BYee7127/LEDWaterFountain/images/LEDStripLightTest.jpg

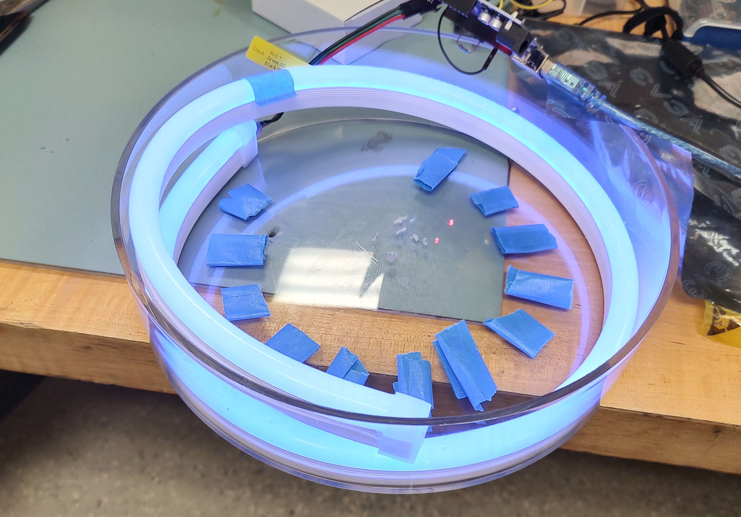
images/LEDStripLightTest.jpg
