BYee7127/LEDWaterFountain/README.md

Mission Statement
The Bellagio's mini-me: a dance of water fountains to the beat of any chosen musical piece and is highlighted by LEDs. 
The height of the water and the intensity or color of the LEDs is determined by the frequency/pitch of the music. 

Final Report:
https://github.com/BYee7127/VisualizeTheInvisible/blob/main/Documents/FinalReport.pdf
