BYee7127/LEDWaterFountain/images/AllResistorsFinished.jpg

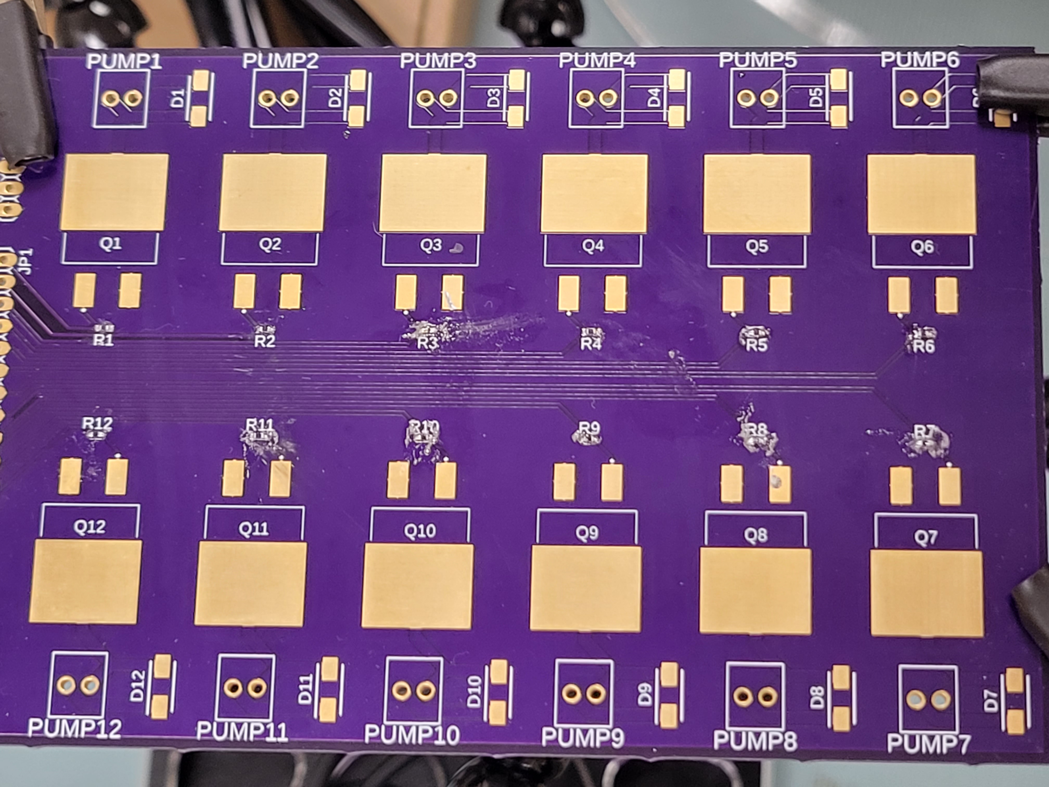
images/AllResistorsFinished.jpg
