BYee7127/LEDWaterFountain/images/AllResistorsFinished_SideView.jpg

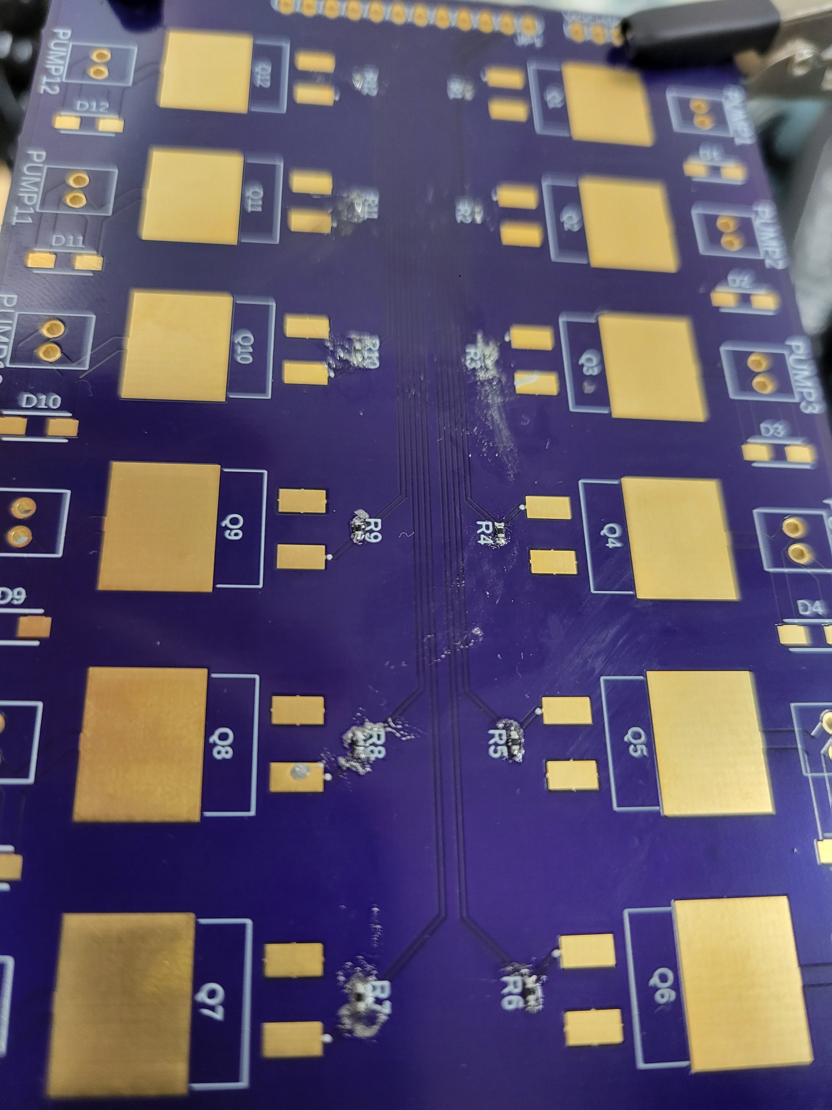
images/AllResistorsFinished_SideView.jpg
