BYee7127/LEDWaterFountain/images/AUXCord.jpg

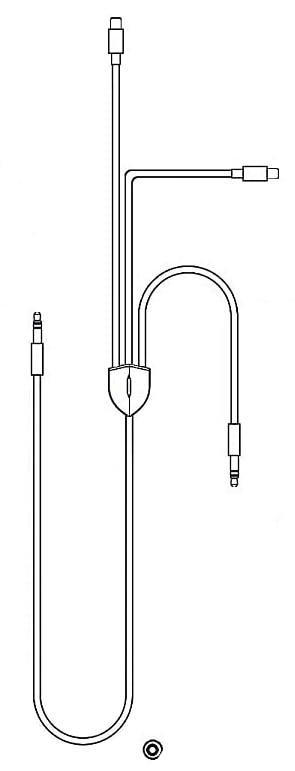
images/AUXCord.jpg
