BYee7127/LEDWaterFountain/images/CompletedCircuitBoard.jpg

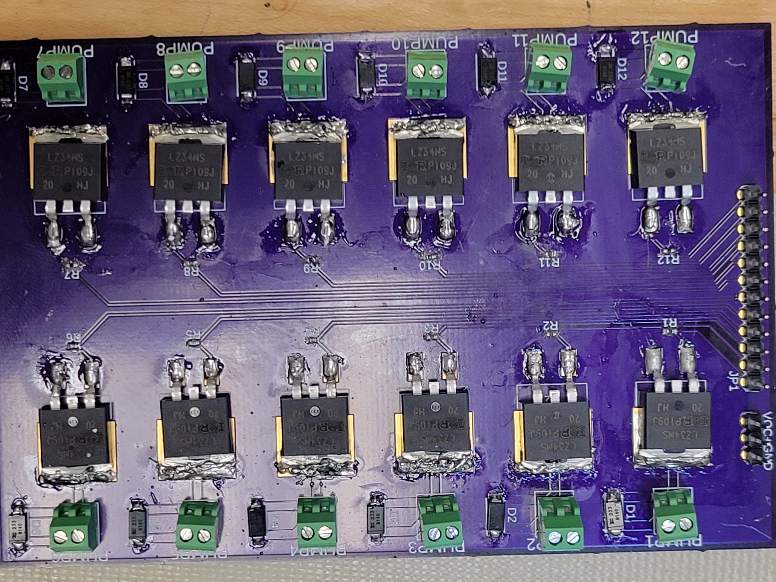
images/CompletedCircuitBoard.jpg
