BYee7127/LEDWaterFountain/images/CutOutTrays.jpg

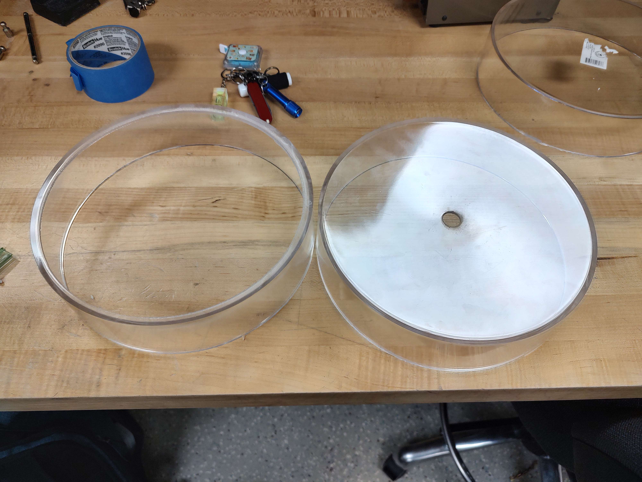
images/CutOutTrays.jpg
