BYee7127/LEDWaterFountain/images/FinishedDriverCloseup.jpg

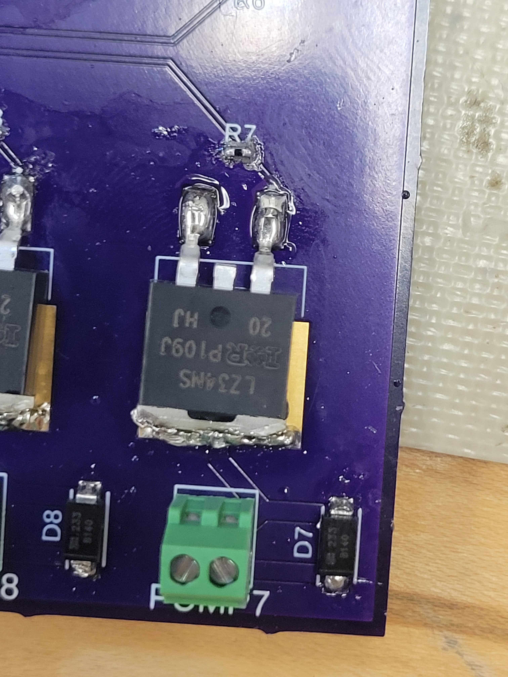
images/FinishedDriverCloseup.jpg
