BYee7127/LEDWaterFountain/images/FinishedDriverx2.jpg

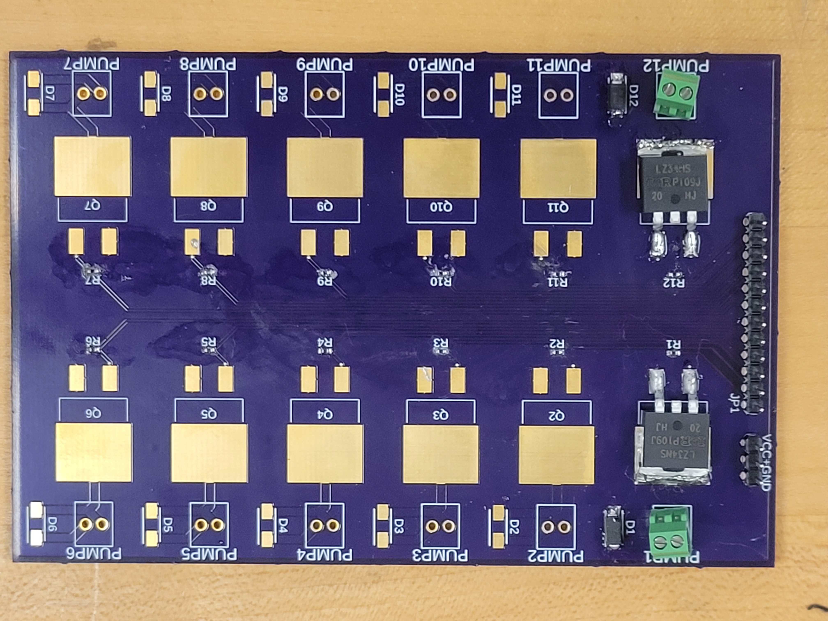
images/FinishedDriverx2.jpg
