BYee7127/LEDWaterFountain/images/PrototypeWithLED.jpg

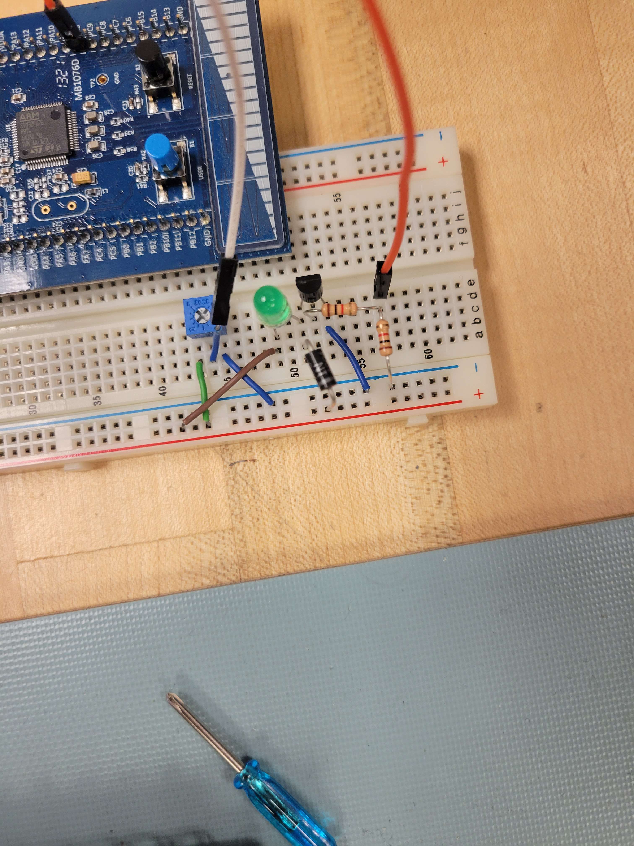
images/PrototypeWithLED.jpg
