BYee7127/LEDWaterFountain/images/PrototypeWithLEDCropped.jpg

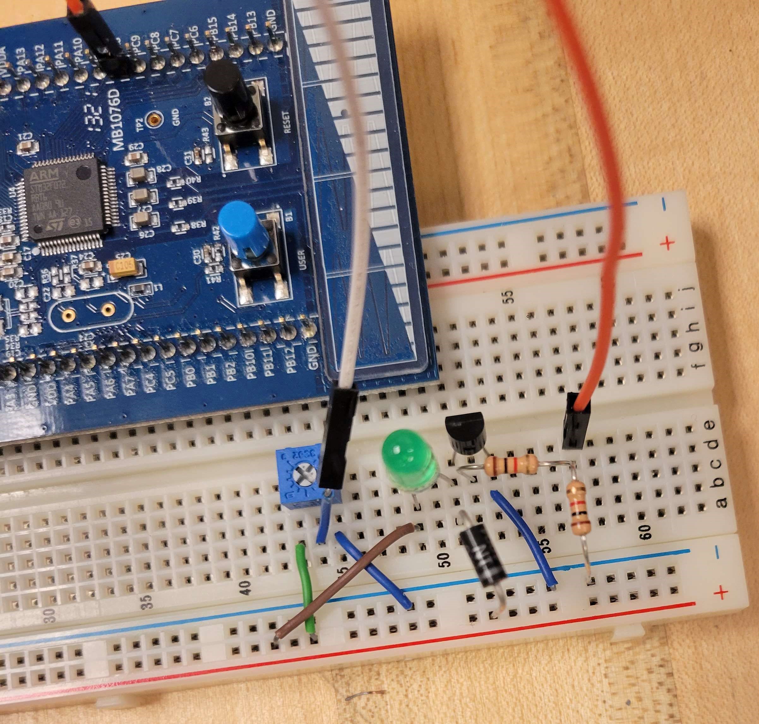
images/PrototypeWithLEDCropped.jpg
