BYee7127/LEDWaterFountain/images/PumpDriverwResistors.jpg

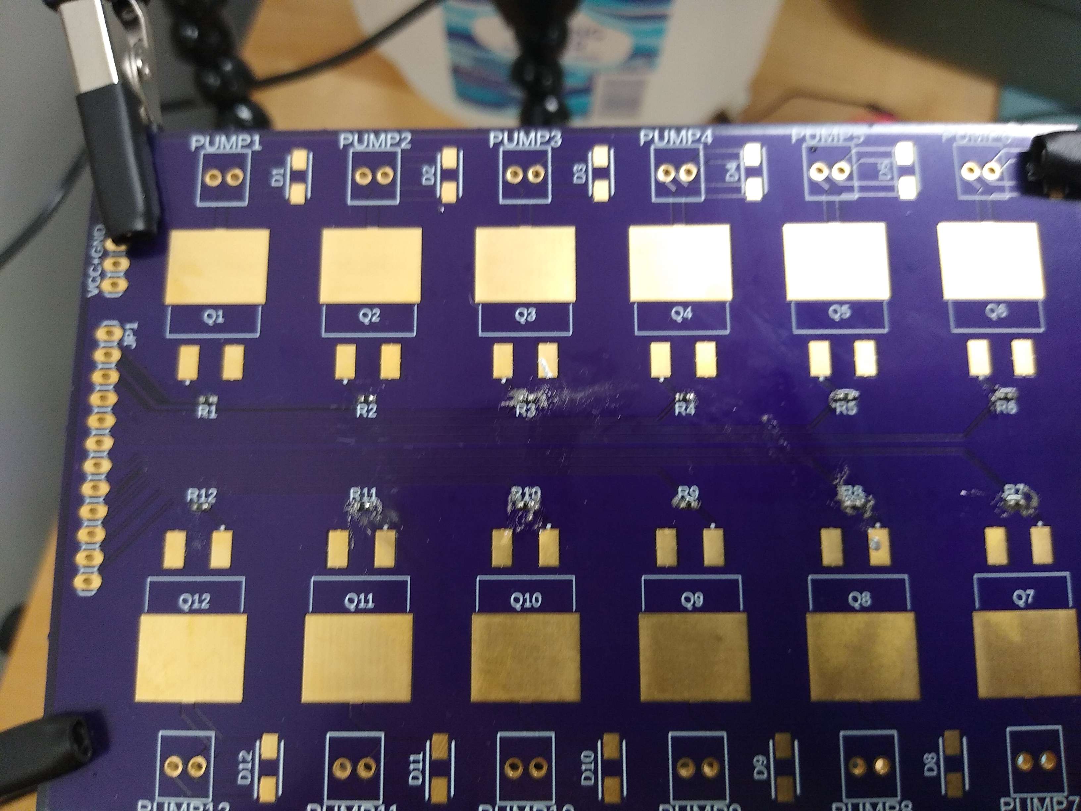
images/PumpDriverwResistors.jpg
