BYee7127/LEDWaterFountain/images/PumpsPositioned.jpg

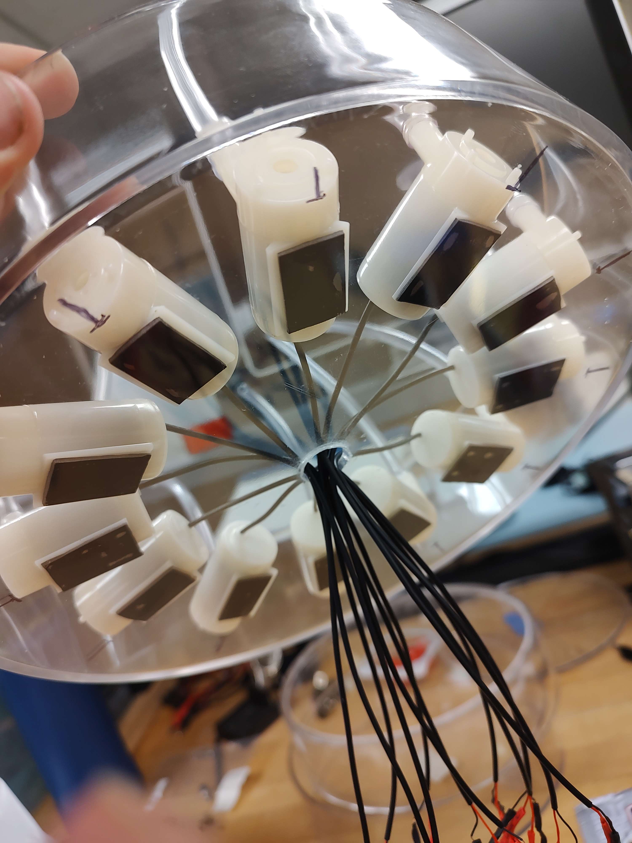
images/PumpsPositioned.jpg
