BYee7127/LEDWaterFountain/images/PumpsPositions_TopView.jpg

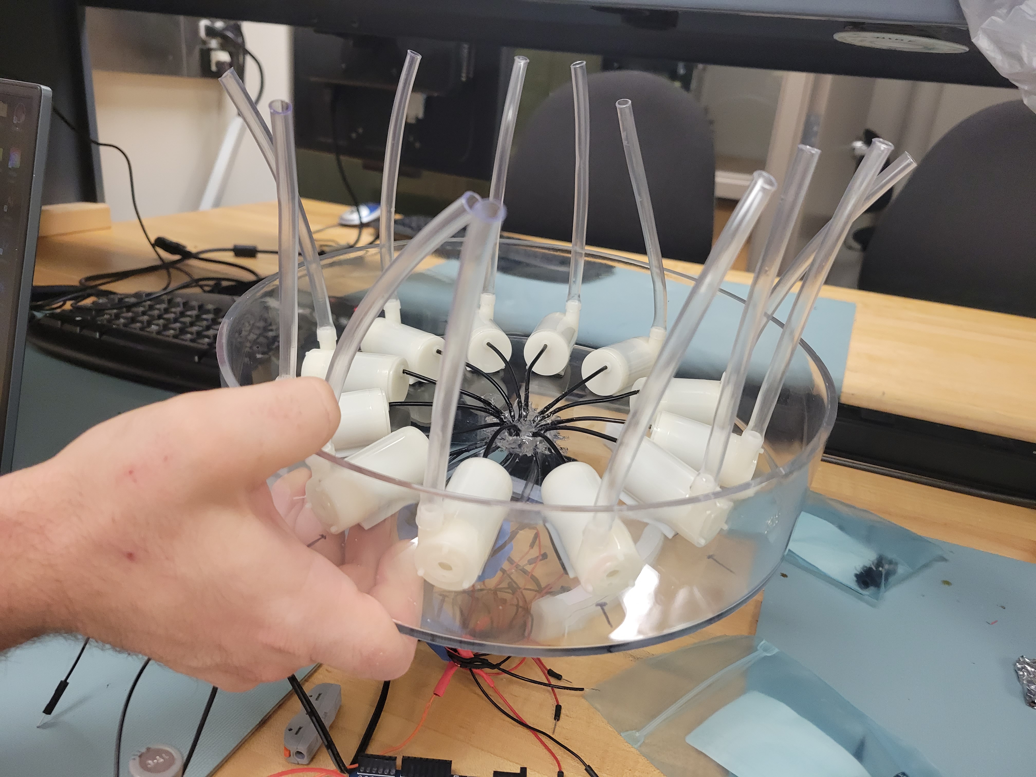
images/PumpsPositions_TopView.jpg
