BYee7127/LEDWaterFountain/images/PWMConnections.jpg

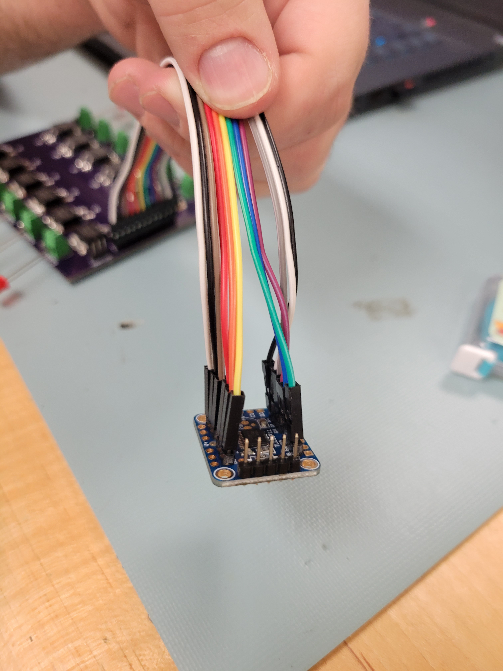
images/PWMConnections.jpg
