BYee7127/LEDWaterFountain/images/StagePreview.jpg

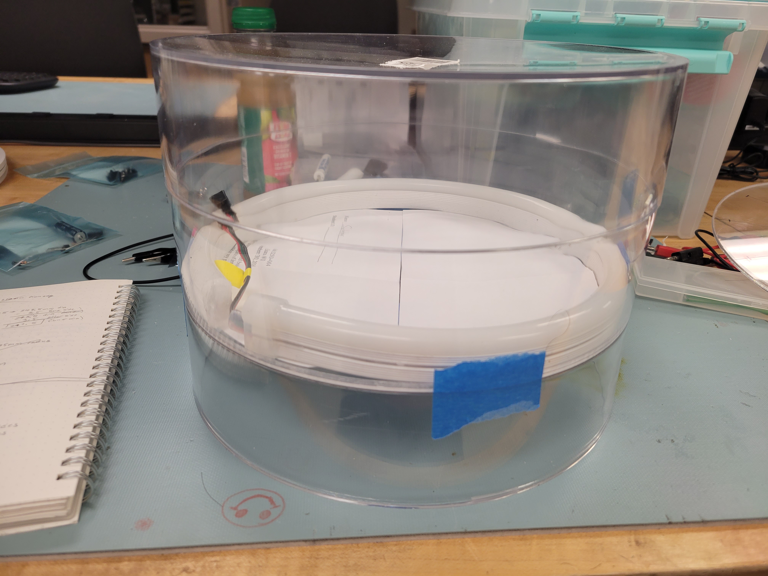
images/StagePreview.jpg
