BYee7127/LEDWaterFountain/images/StagePreview_TopView.jpg

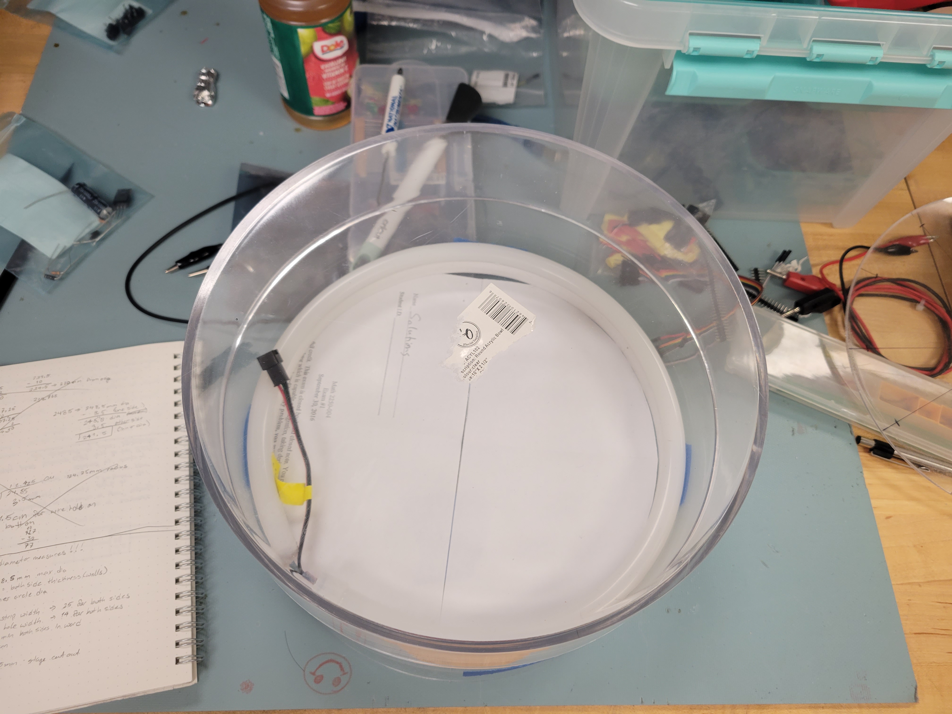
images/StagePreview_TopView.jpg
