BYee7127/LEDWaterFountain/images/StageWithTubeHolesOnlySide.jpg

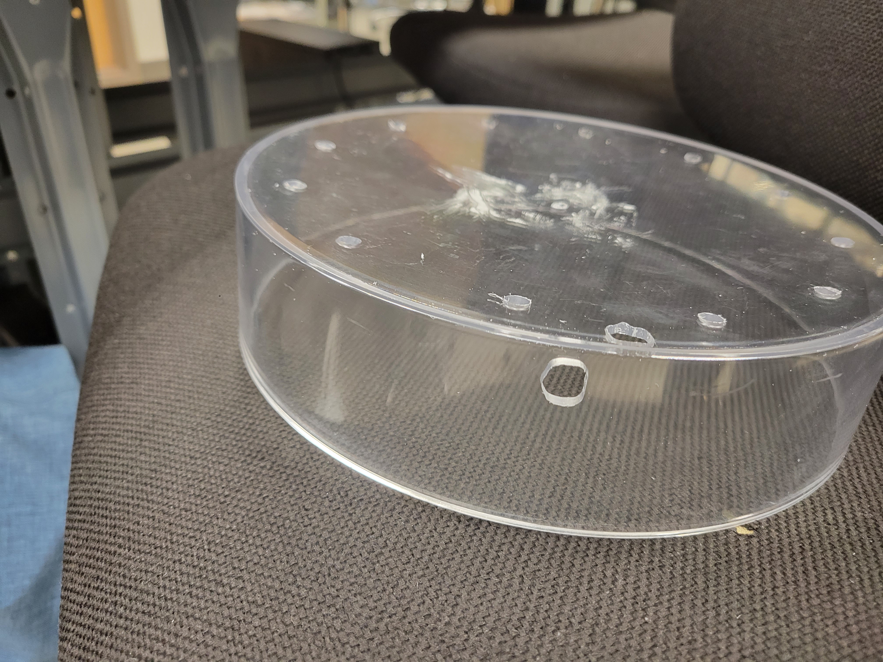
images/StageWithTubeHolesOnlySide.jpg
