BYee7127/LEDWaterFountain/images/Stand+RightSpeakerFront.jpg

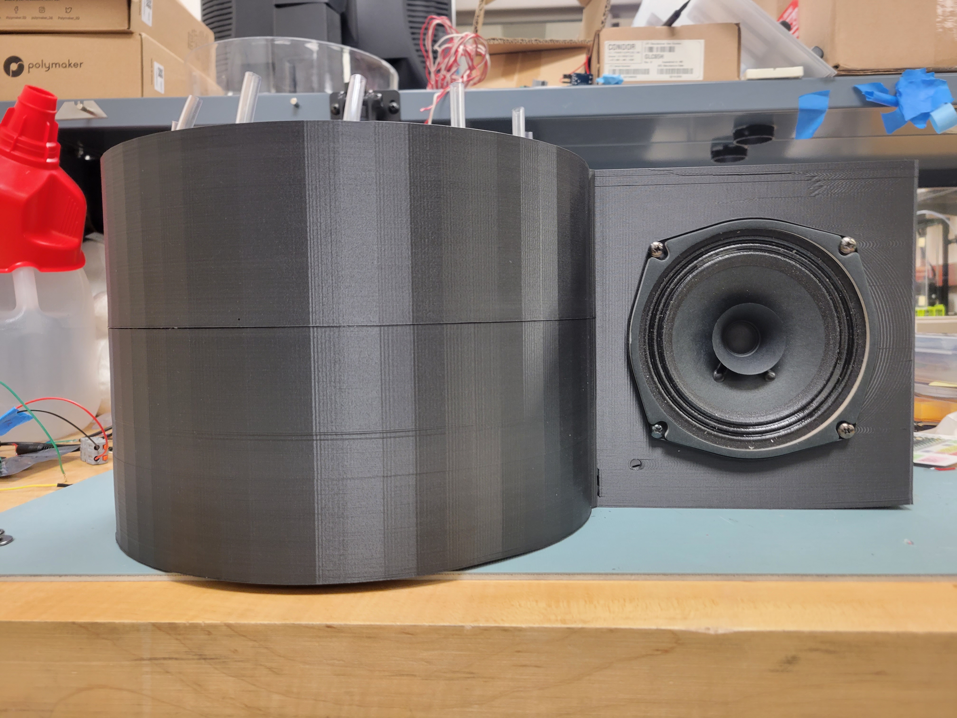
images/Stand+RightSpeakerFront.jpg
