BYee7127/LEDWaterFountain/images/Stand+RightSpeakerTop.jpg

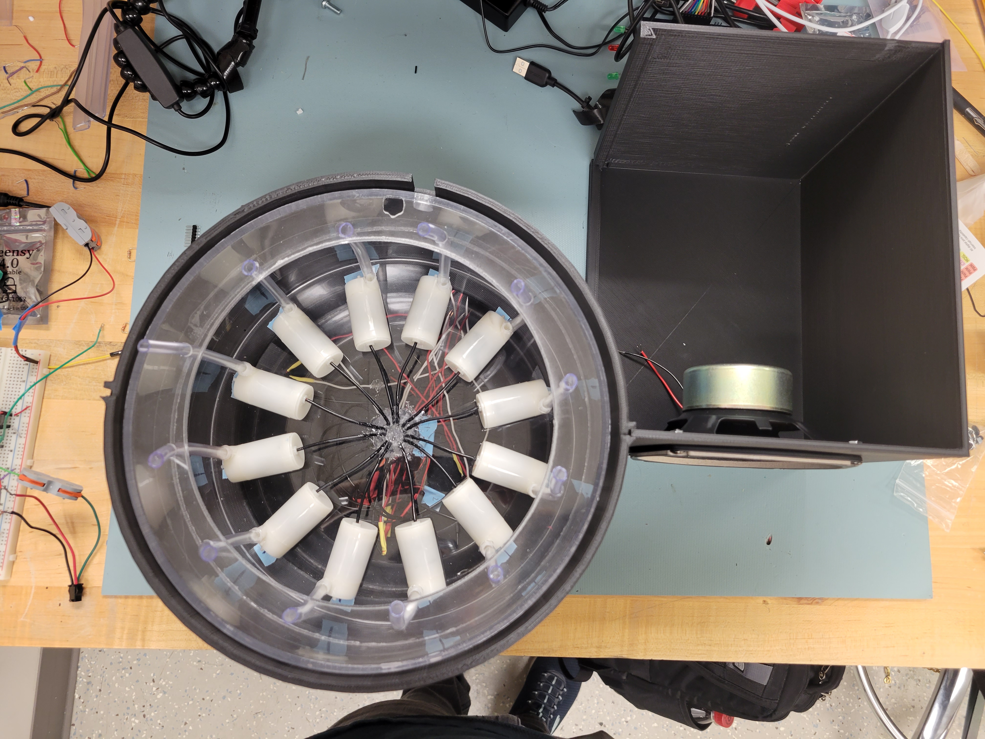
images/Stand+RightSpeakerTop.jpg
