BYee7127/LEDWaterFountain/images/Stand+RightSpeakerTopFront.jpg

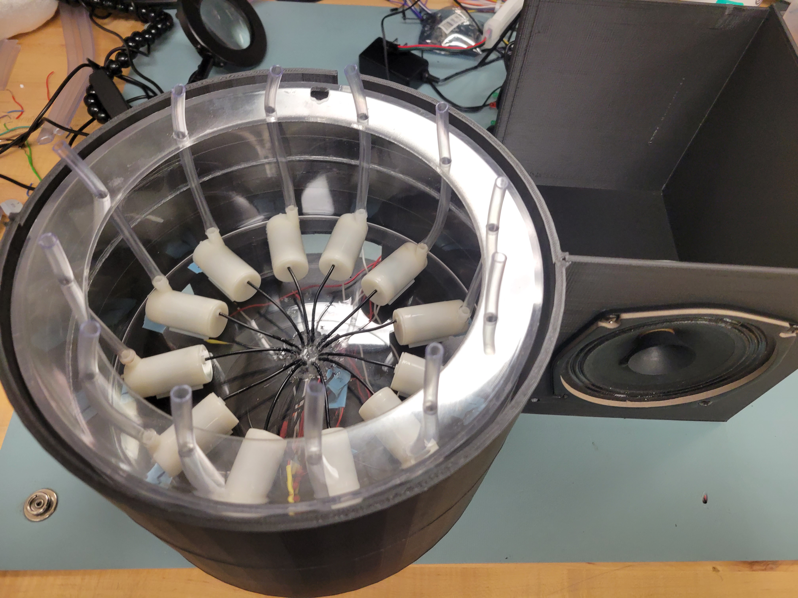
images/Stand+RightSpeakerTopFront.jpg
