BYee7127/LEDWaterFountain/images/teensy40_card10a_rev2.png

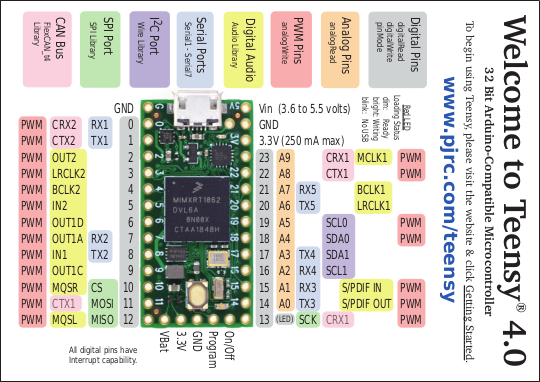
images/teensy40_card10a_rev2.png
