BYee7127/LEDWaterFountain/images/TentSideView.jpg

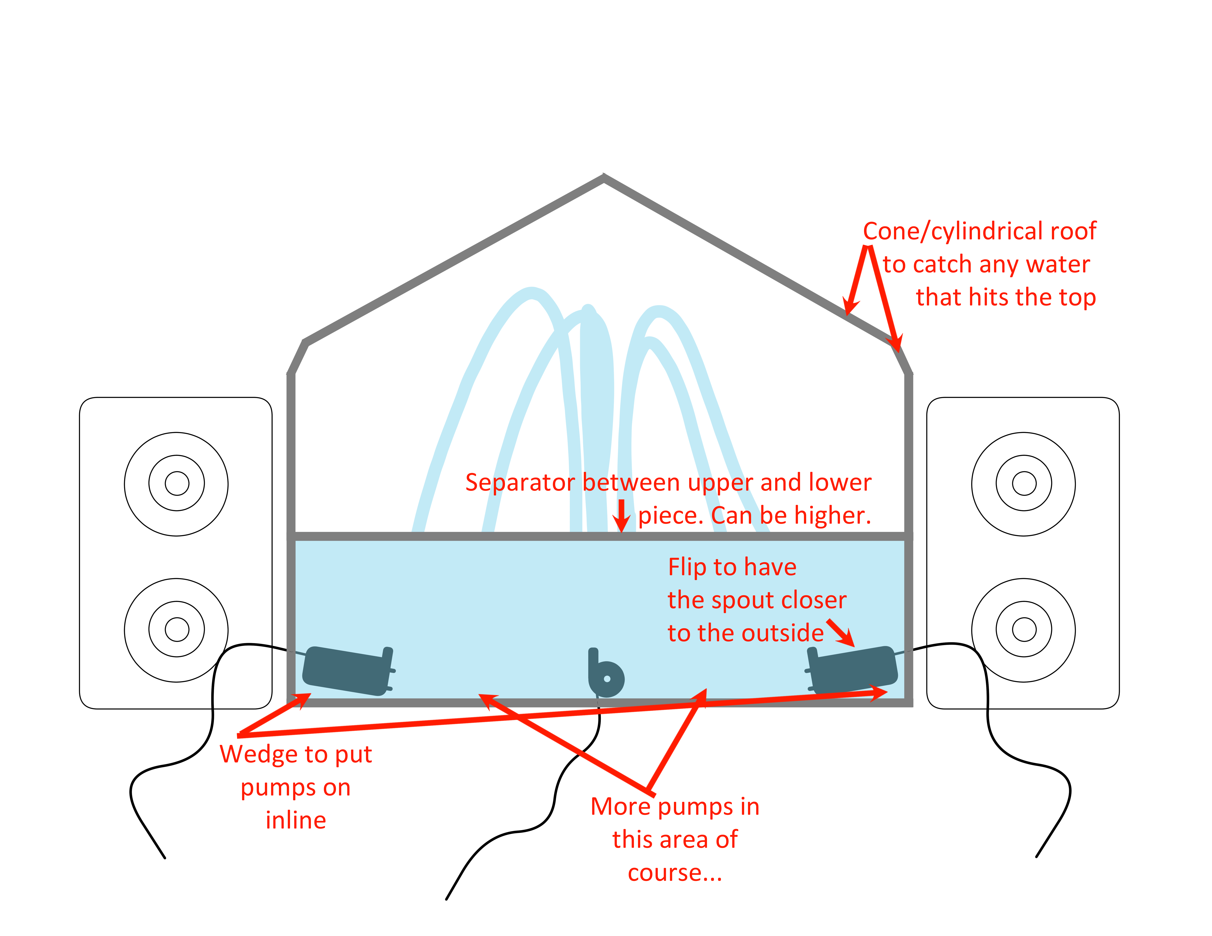
images/TentSideView.jpg
