BYee7127/LEDWaterFountain/images/TentTopView.jpg

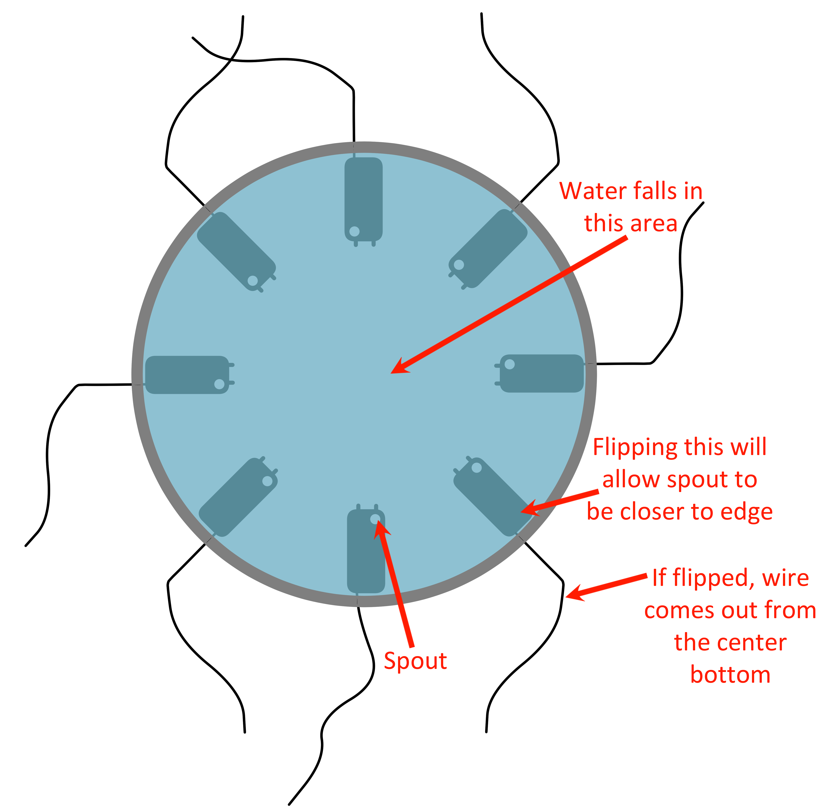
images/TentTopView.jpg
