BYee7127/LEDWaterFountain/images/WaterFountainStandTinkercad.png

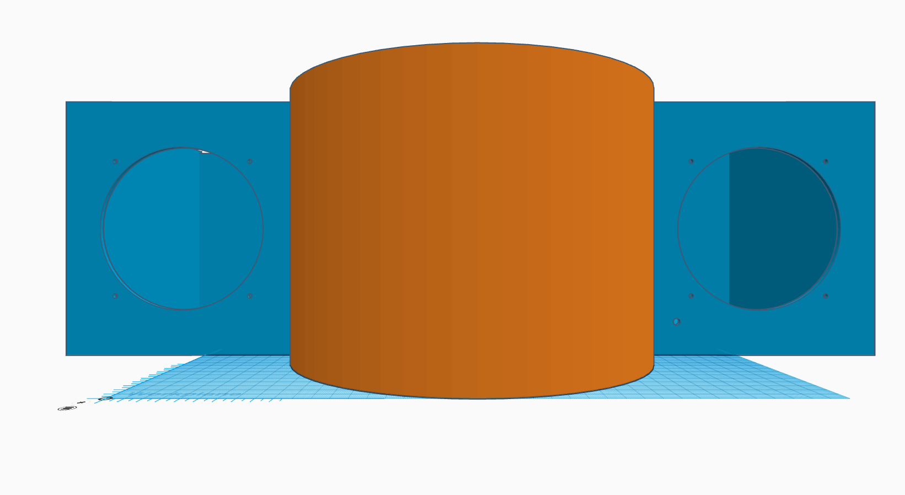
images/WaterFountainStandTinkercad.png
