BYee7127/LEDWaterFountain/Documents/Digi-Key Order.xlsx

# | QUANTITY | PART NUMBER | MANUFACTURER PART NUMBER | DESCRIPTION | CUSTOMER REFERENCE | BACKORDER | UNIT PRICE | EXTENDED PRICE
1 | 3 | 2092-STX-3120-3B-ND | STX-3120-3B | CONN JACK STEREO 3.5MM PCB R/A |  | 0 | 0.84 | 2.52
2 | 16 | IRLZ34NSTRLPBFCT-ND | IRLZ34NSTRLPBF | MOSFET N-CH 55V 30A D2PAK |  | 0 | 1.53 | 24.48
3 | 16 | 311-1.00KLRCT-ND | RC0402FR-071KL | RES 1K OHM 1% 1/16W 0402 |  | 0 | 0.015 | 0.24
4 | 16 | B140-FDICT-ND | B140-13-F | DIODE SCHOTTKY 40V 1A SMA |  | 0 | 0.316 | 5.06
5 | 16 | A98333-ND | 282834-2 | TERM BLK 2P SIDE ENT 2.54MM PCB |  | 0 | 1.288 | 20.61
