BYee7127/LEDWaterFountain/Documents/ExpensesCalculator.xlsx

Item | Item # | Purchase Date | Vendor | Qty (ea) | Price (ea) | Alex | Bev | Comments
water pumps |  |  |  |  |  | 45.44
trays |  |  |  |  |  |  | 44.02
sealant |  |  |  |  |  | 7.51
double sided tape |  |  |  |  |  | 9.63
clear tape |  |  |  |  |  | 8.97
acrylic sheets |  |  |  |  |  | 8.88
pcb |  |  |  |  |  | 71.45
power supply |  |  |  |  |  |  | 17.69
audio port |  |  |  |  |  |  | 2.52
transistors |  |  |  |  |  |  | 24.48
resistors |  |  |  |  |  |  | 0.24
diodes |  |  |  |  |  |  | 5.06
terminal blocks |  |  |  |  |  |  | 20.61
digi-key fees |  |  |  |  |  |  | 11.45
solder paste |  | 2023-05-12 |  |  |  |  | 12.82
LED strip lights |  |  |  |  |  |  | 73.96
contour tool |  | 2023-04-19 |  |  |  |  | 11.79
electronic silicone |  | 2023-08-07 |  |  |  |  | 10.67
shears |  | 2023-07-13 |  |  |  | 12.53
Audio adapter |  | 2023-08-31 |  |  |  | 13.25
PLA filament |  | 2023-08-31 |  |  |  | 22.51
H clip hinge |  | 2023-08-31 |  |  |  | 25.73
Teensy 4.0 |  | 2023-09-16 |  |  |  | 25.73 |  | 23.99
PLA filament |  | 2023-10-10 |  |  |  | 36.02
RainX water repellent |  | 2023-12-03 |  |  |  | 7.7
 |  |  |  |  |  | 295.35 | 235.31
 |  |  |  |  |  | 530.66
 |  |  |  |  |  |  | 3.98
 |  |  |  |  |  |  | 6.98
 |  |  |  |  |  |  | 10.48
 |  |  |  |  |  |  | 8.98
 |  |  |  |  |  |  | 265.73
