BYee7127/LEDWaterFountain/images/ASolderedResistor.jpg

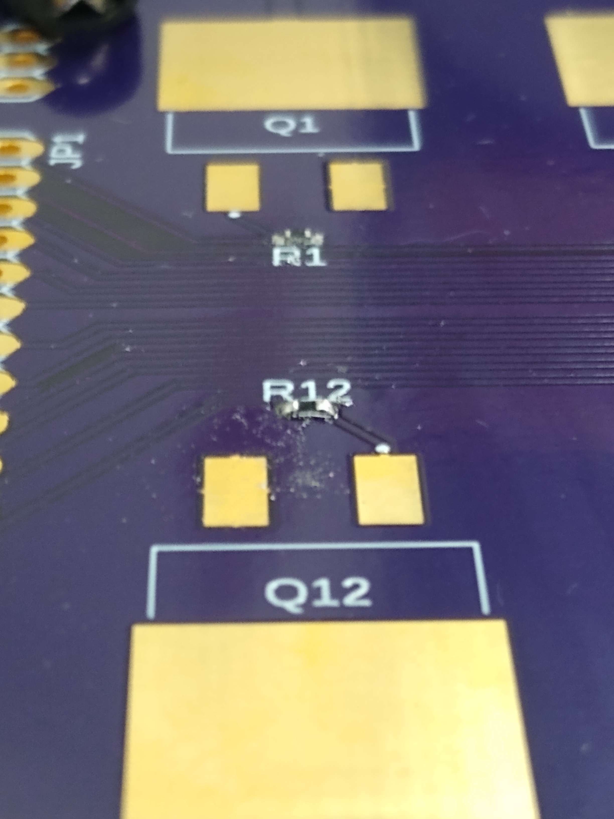
images/ASolderedResistor.jpg
