BYee7127/LEDWaterFountain/images/CircuitAssembly.jpg

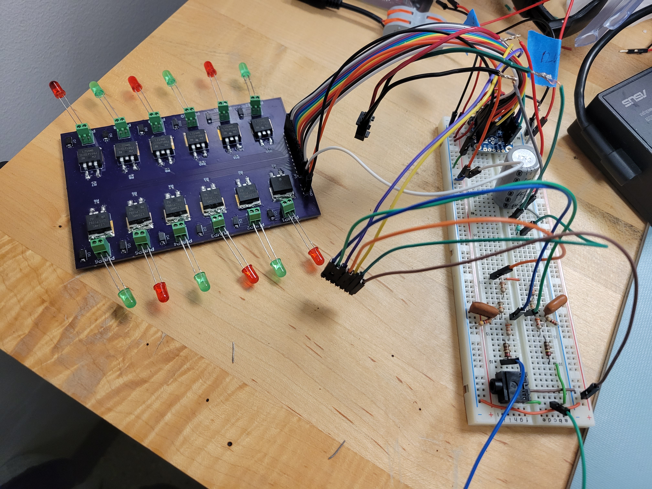
images/CircuitAssembly.jpg
