BYee7127/LEDWaterFountain/images/FullTrayMockAssemblyTopSide.jpg

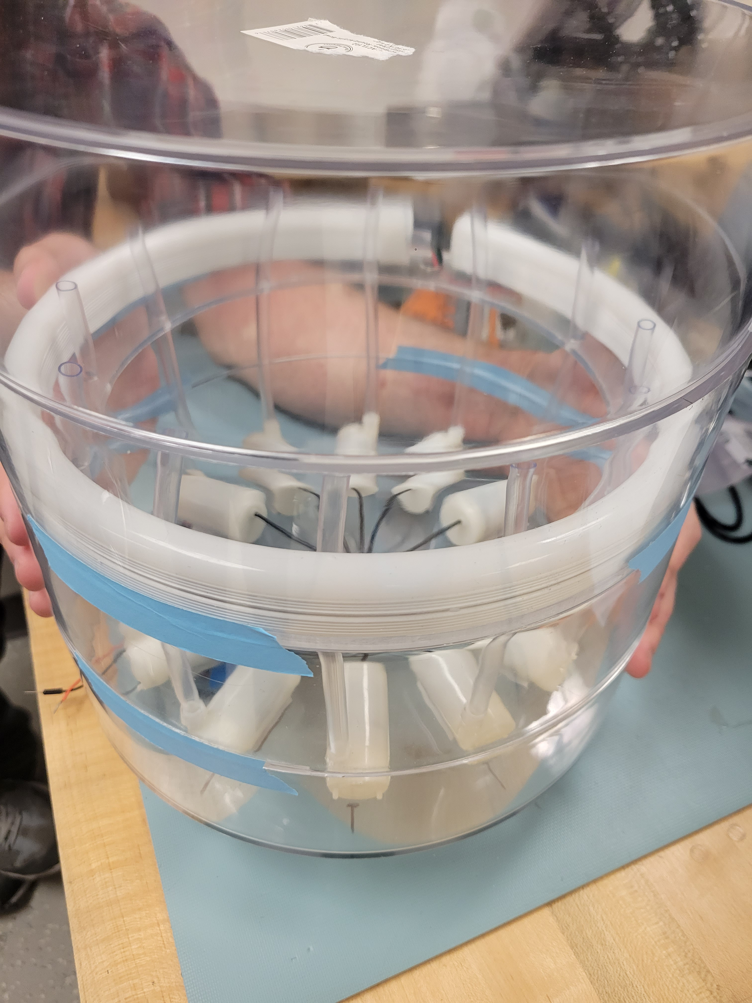
images/FullTrayMockAssemblyTopSide.jpg
