BYee7127/LEDWaterFountain/images/PoolCoverStandPartialPrint.jpg

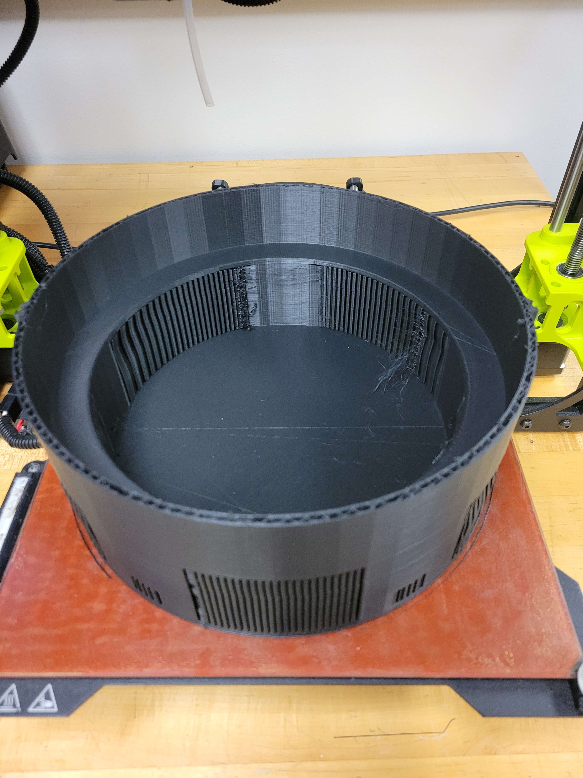
images/PoolCoverStandPartialPrint.jpg
