BYee7127/LEDWaterFountain/images/PoolMockAssembly.jpg

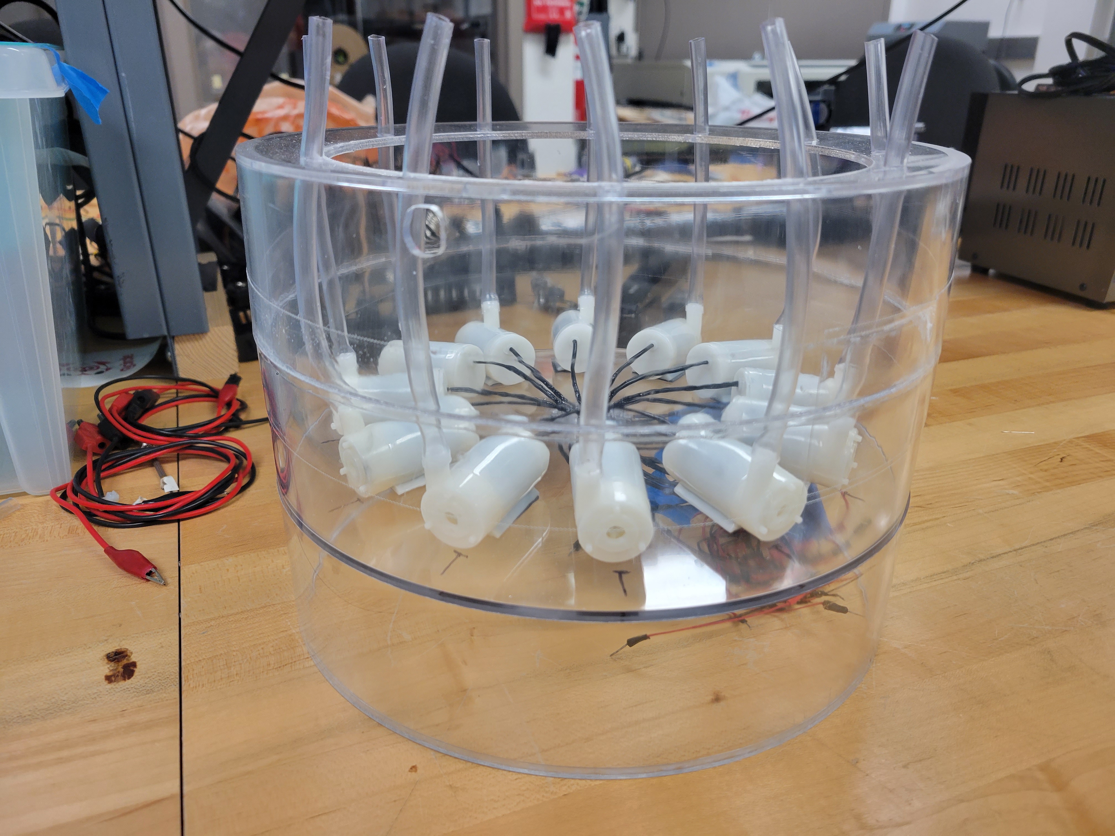
images/PoolMockAssembly.jpg
