BYee7127/LEDWaterFountain/images/SolderedPumps.jpg

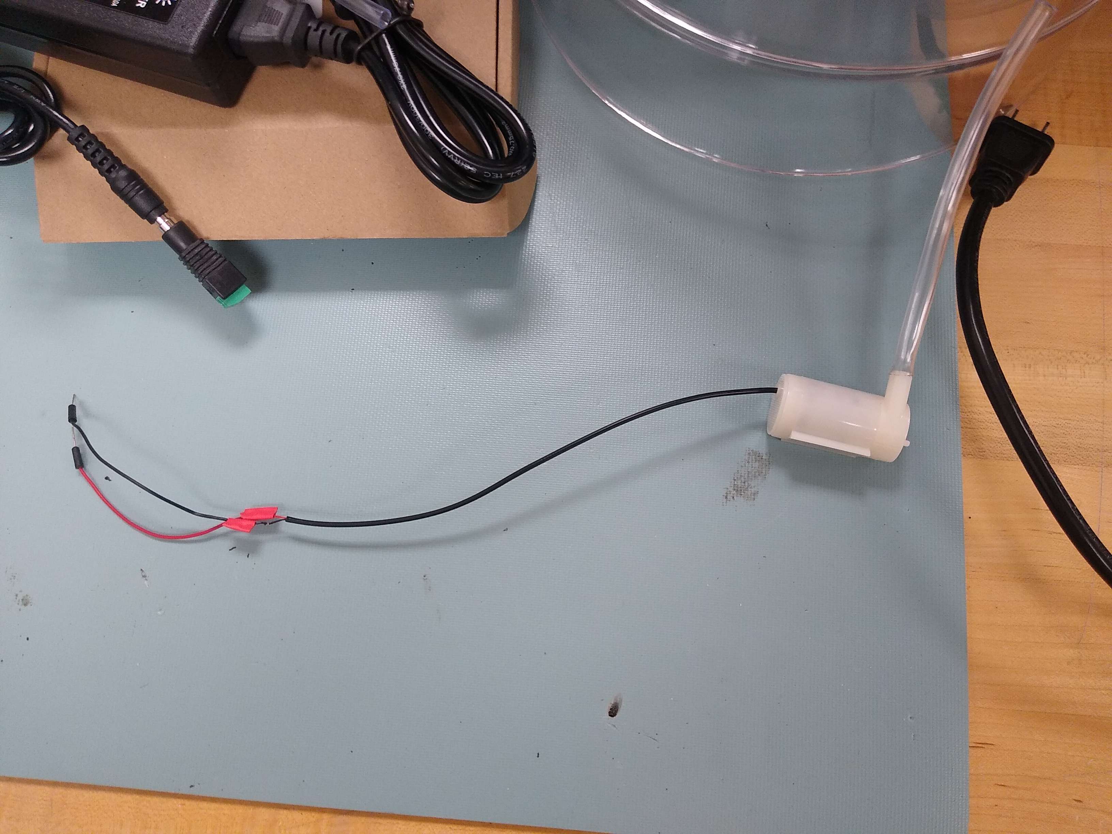
images/SolderedPumps.jpg
