BYee7127/LEDWaterFountain/images/SolderedResistorsx3.jpg

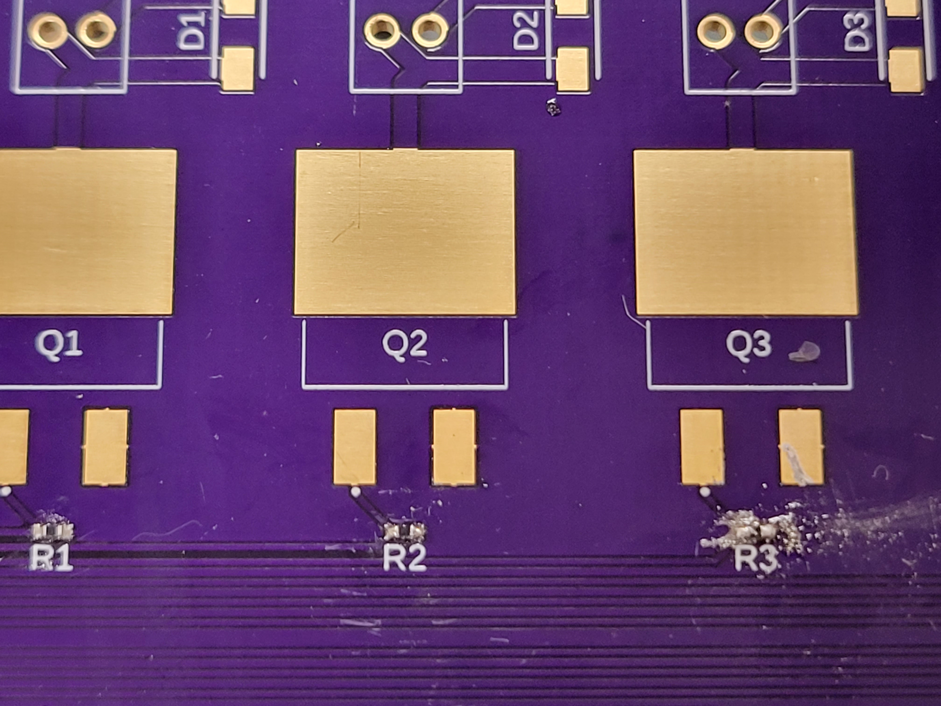
images/SolderedResistorsx3.jpg
