BYee7127/LEDWaterFountain/images/3DPoolCoverTest.jpg

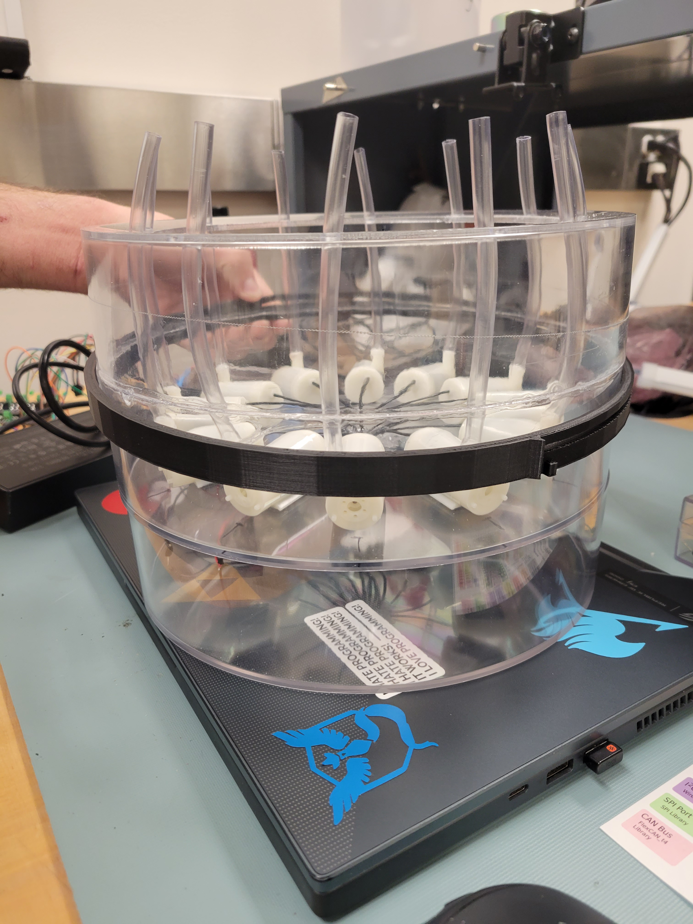
images/3DPoolCoverTest.jpg
