BYee7127/LEDWaterFountain/images/Speaker3DPrintTestFit.jpg

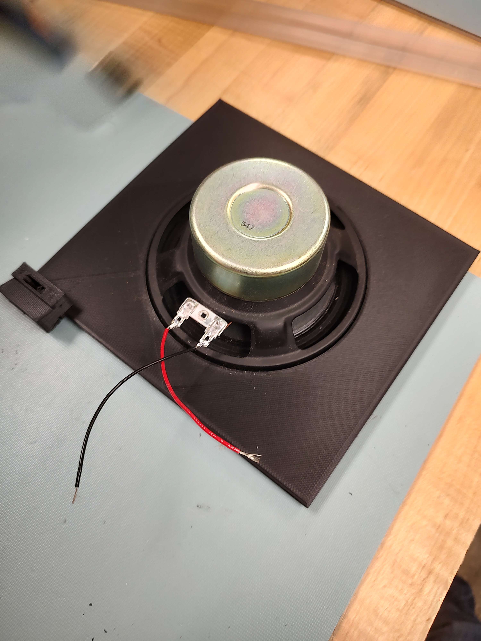
images/Speaker3DPrintTestFit.jpg
