BYee7127/LEDWaterFountain/images/testjoints.jpg

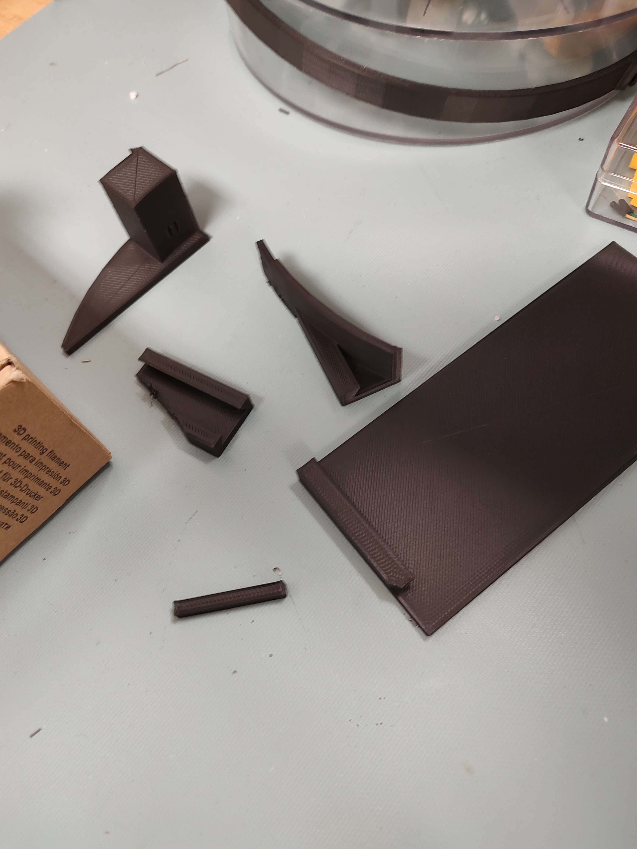
images/testjoints.jpg
