BYee7127/LEDWaterFountain/Documents/pump.pdf

# M3 M7 M11 M15

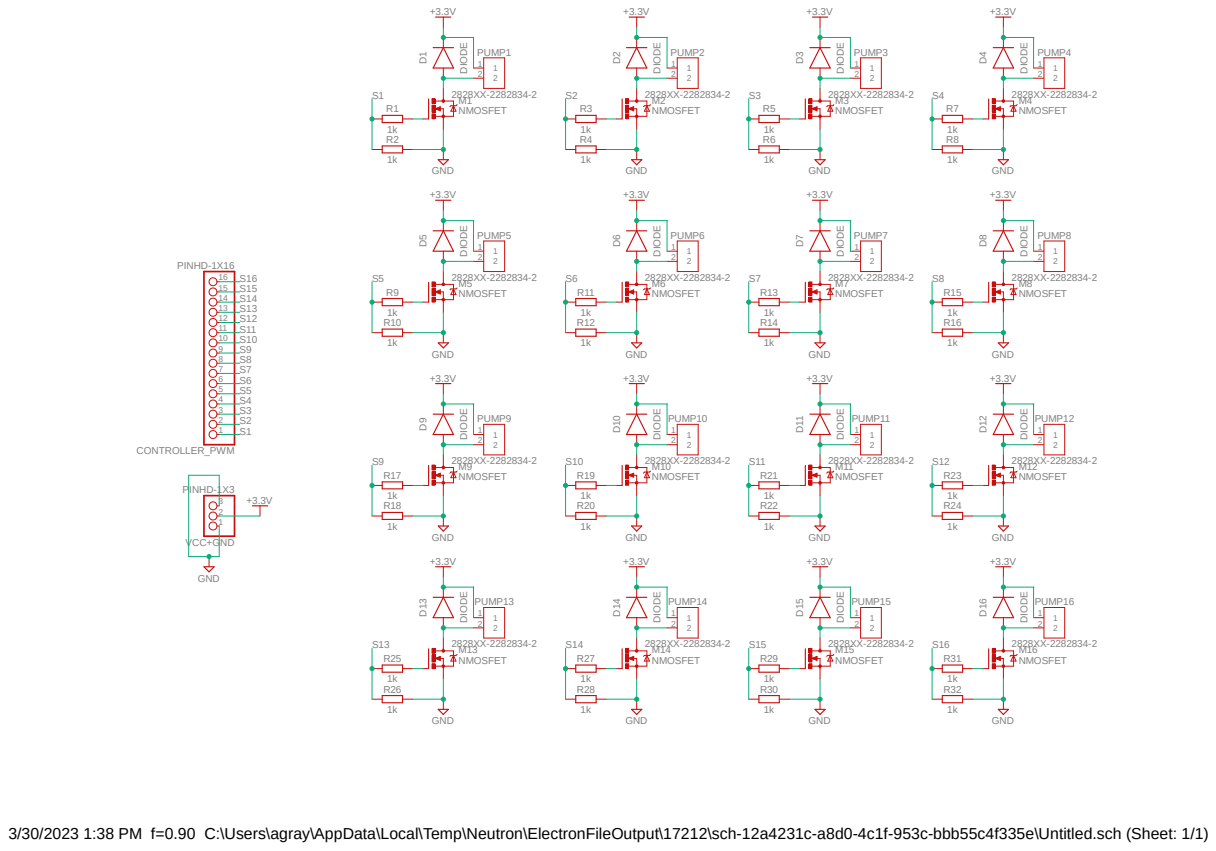
[picture p67: page 1]

3/30/2023 1:38 PM f=0.90 C:\Users\agray\AppData\Local\Temp\Neutron\ElectronFileOutput\17212\sch-12a4231c-a8d0-4c1f-953c-bbb55c4f335e\Untitled.sch (Sheet: 1/1)
