BYee7127/LEDWaterFountain/(commit log)

2023-04-25 added stm32 code
2023-04-27 Prototype document & sketches (BY)
2023-05-06 Added prototype video (BY)
2023-05-06 Updated website with current info (BY)
2023-05-06 Expenses stuff (BY)
    [Digi-Key Order.xlsx, ExpensesCalculator.xlsx]
2023-05-31 Added meeting info (BCY)
    [ExpensesCalculator.xlsx]
2023-06-19 added 11 other pwm channels
2023-07-23 multiple channels of pwm output
2023-08-23 Pics and Arduino code (BCY)
2023-08-29 Pumps Attached, tray finished images (BCY)
    [ExpensesCalculator.xlsx]
2023-08-29 Updated website to reflect current status (BCY)
2023-08-31 updated expenses
    [ExpensesCalculator.xlsx]
2023-09-09 Added Documents to separate and declutter (BCY)
    [Digi-Key Order.xlsx, ExpensesCalculator.xlsx]
2023-10-17 Updating expenses and meetings (BCY)
    [ExpensesCalculator.xlsx]
2023-10-17 Added photo of 3d printed joints (BCY)
2023-11-14 updated averageFFT() to use correct function
    [WaterFountainMain.ino]
2023-11-21 successful test of pumps
2023-11-21 LED random color helper; comments (BCY)
2023-11-28 fft to pumps code
2023-11-29 deleted old code from stm32
2023-12-05 Updating LEDs to use counter
    [ExpensesCalculator.xlsx]
2023-12-05 Revising LEDs again for counter (BCY)
2023-12-07 Resolved merge conflict (BCY)
    [WaterFountainMain.ino]
