BYee7127/LEDWaterFountain/images/PCBtoPWMConnection.jpg

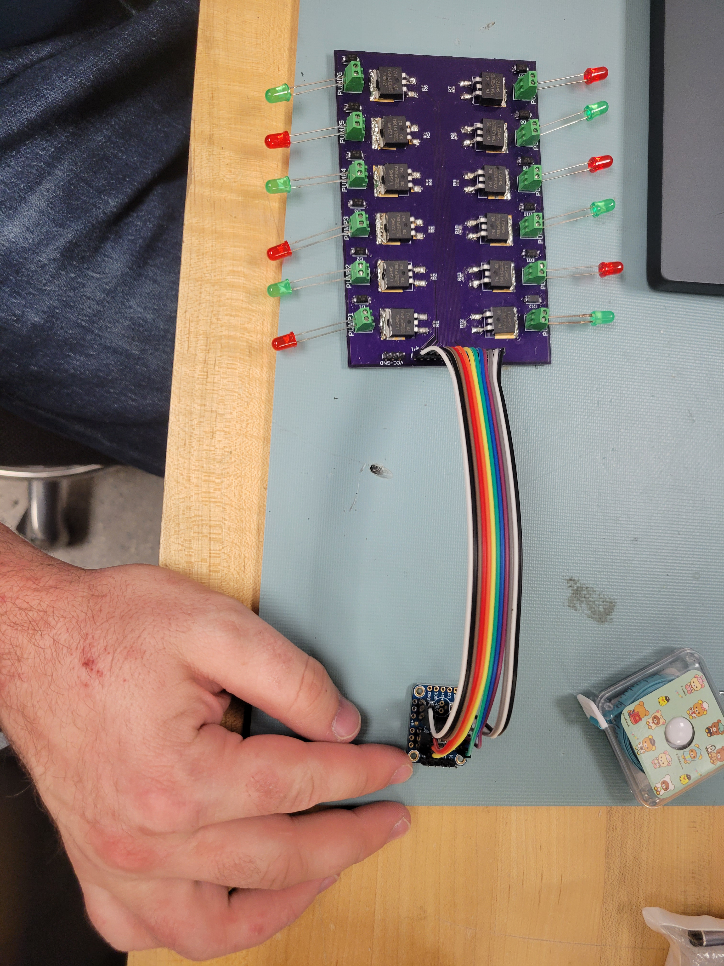
images/PCBtoPWMConnection.jpg
