BYee7127/LEDWaterFountain/images/AssembledEnclosure.jpg

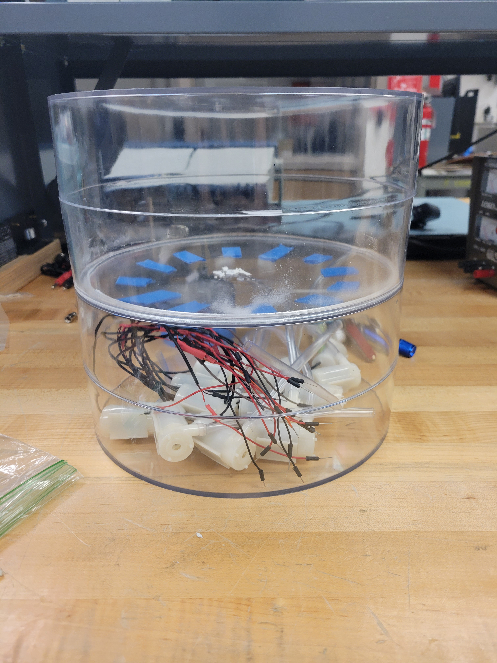
images/AssembledEnclosure.jpg
