BYee7127/LEDWaterFountain/images/AssembledEnclosure_TopView.jpg

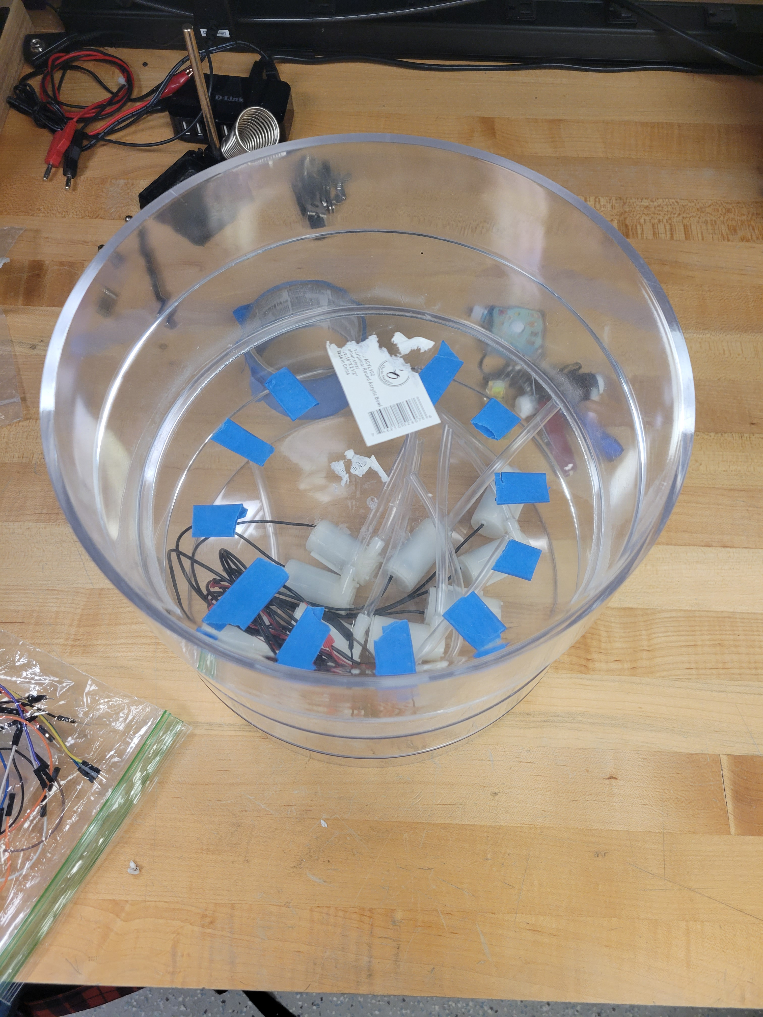
images/AssembledEnclosure_TopView.jpg
