BYee7127/LEDWaterFountain/images/FullTrayMockAssemblyTop2.jpg

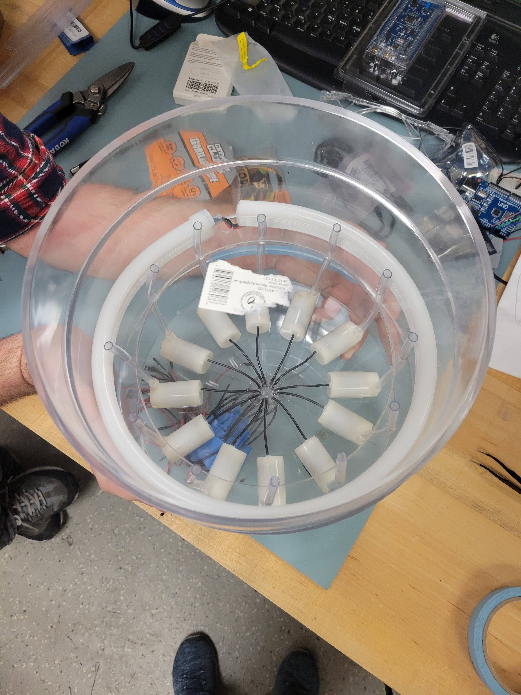
images/FullTrayMockAssemblyTop2.jpg
