BYee7127/LEDWaterFountain/images/FullTrayMockAssemblyTop.jpg

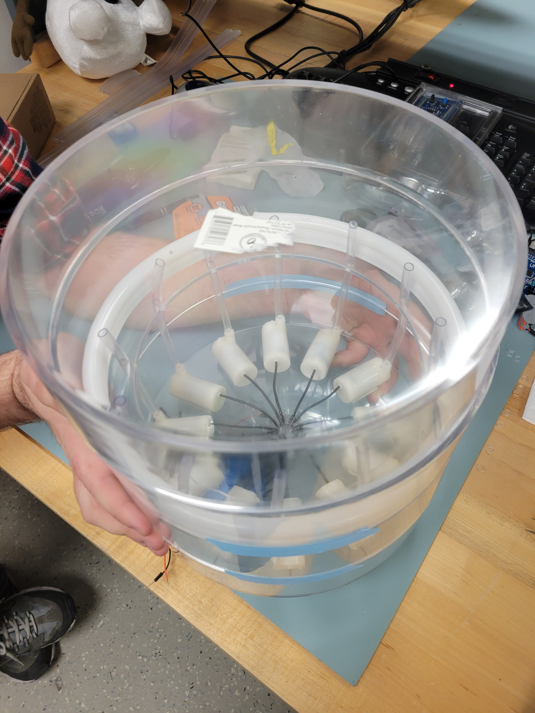
images/FullTrayMockAssemblyTop.jpg
