BYee7127/LEDWaterFountain/images/FullTrayMockAssembly.jpg

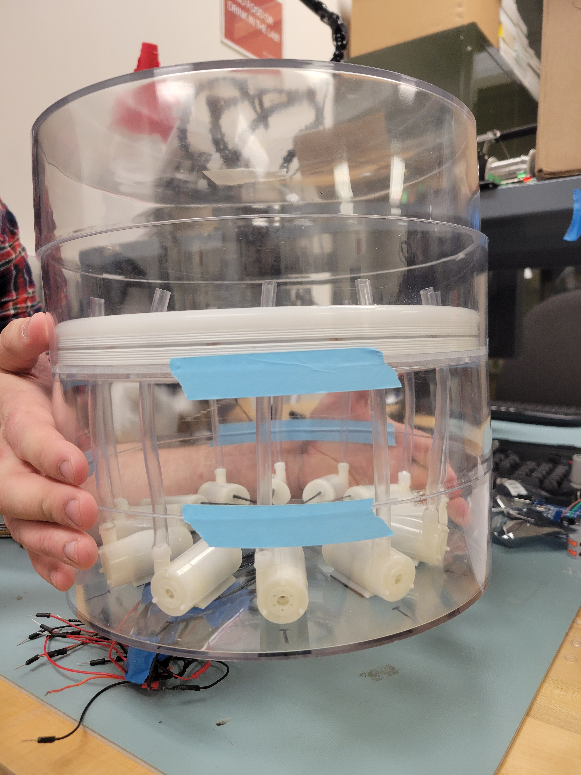
images/FullTrayMockAssembly.jpg
