BYee7127/LEDWaterFountain/images/3DPoolCoverTestSide.jpg

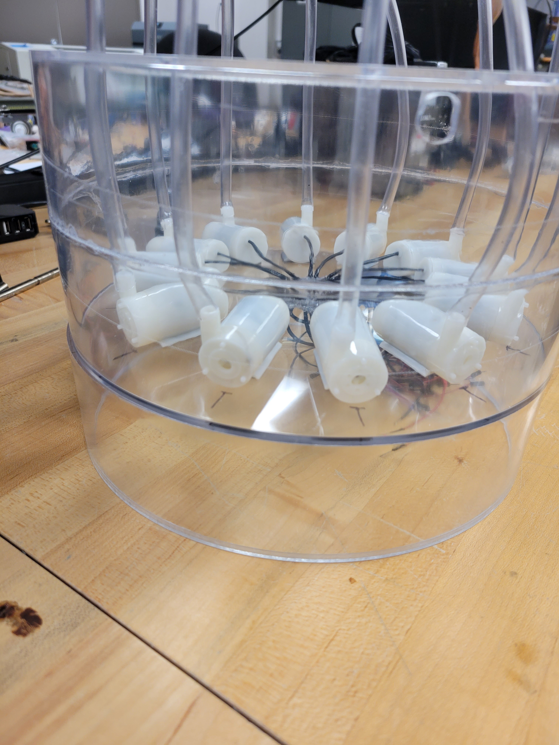
images/3DPoolCoverTestSide.jpg
