BYee7127/LEDWaterFountain/images/CircuitTestWithLEDs.jpg

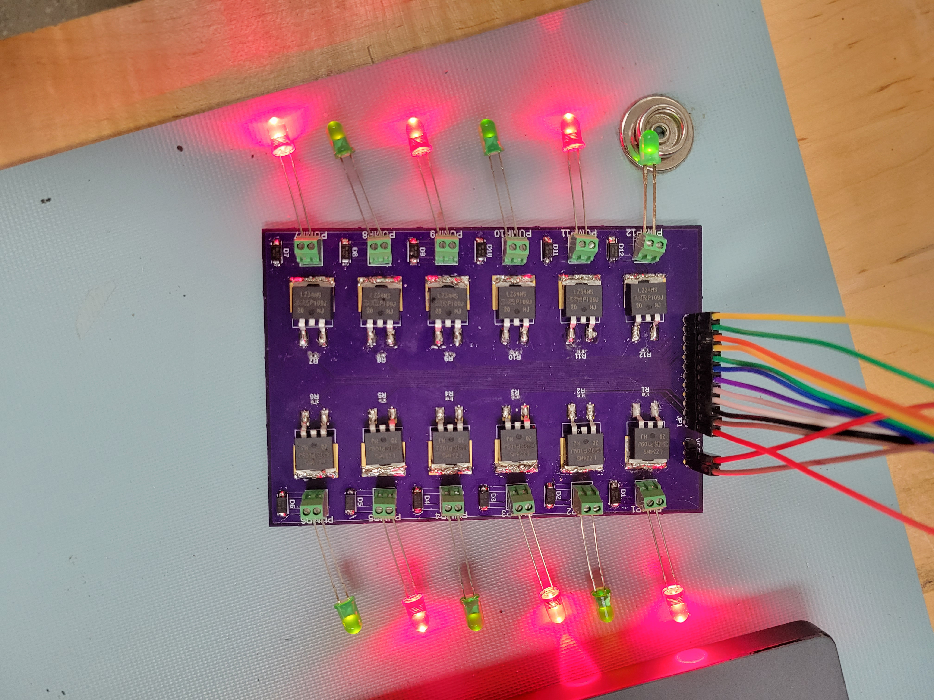
images/CircuitTestWithLEDs.jpg
